VE3EZB/Remote-AE-Tuner/Diagram.pdf

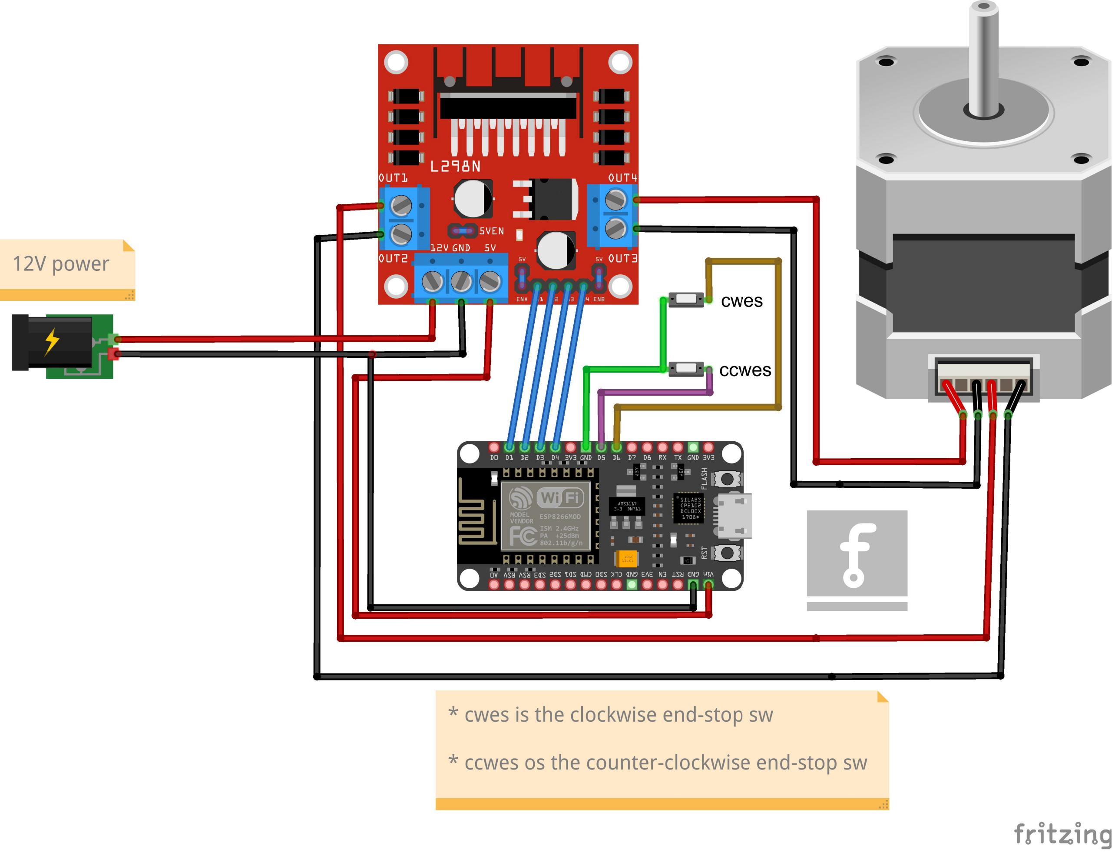
[picture p1: figure]
